Rollpopptery/wombat2/README.md

# Wombat II

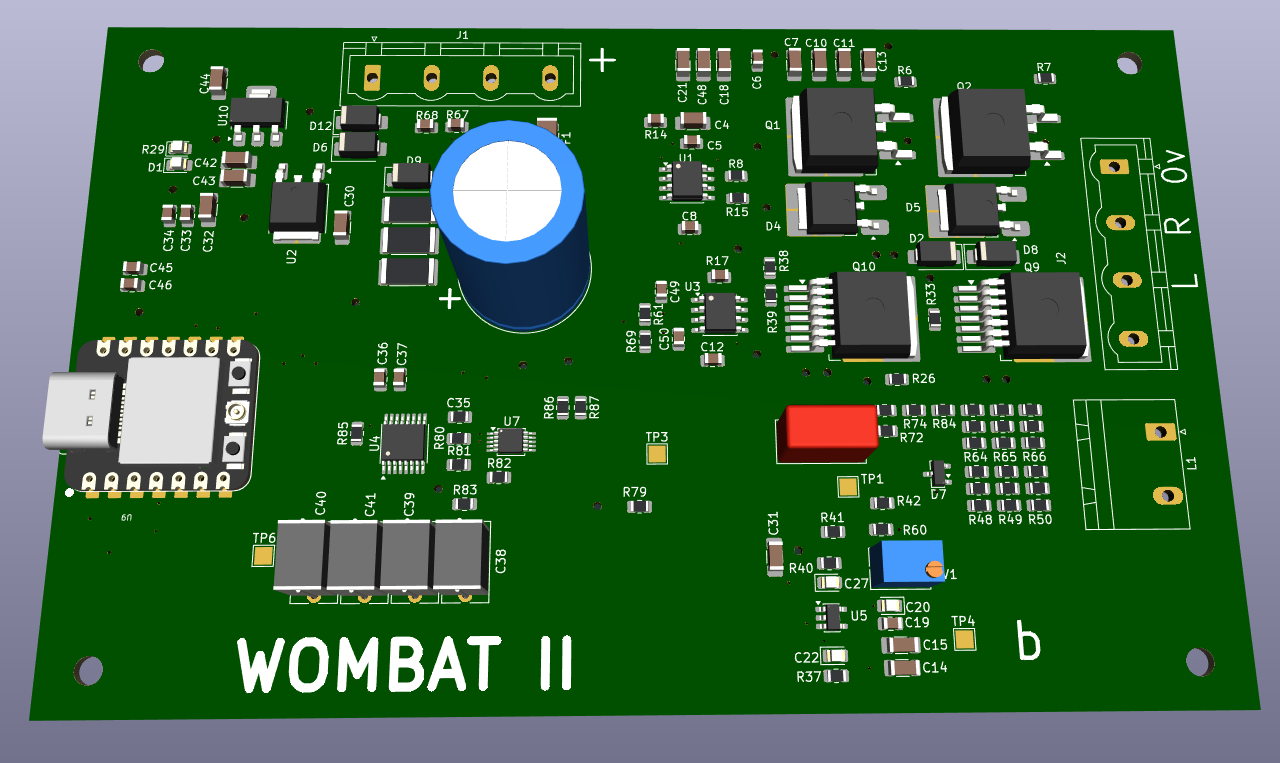
[picture p1: images/wombat2-pcb.png]
Wombat II PCB


## Repository layout

- `circuit/` — KiCad schematic and PCB design
- `software/` — all software
