Rollpopptery/wombat2/circuit/wombat2/wombat2.kicad_pcb

## KiCad design circuit/wombat2/wombat2.kicad_pcb (2026-08-06)

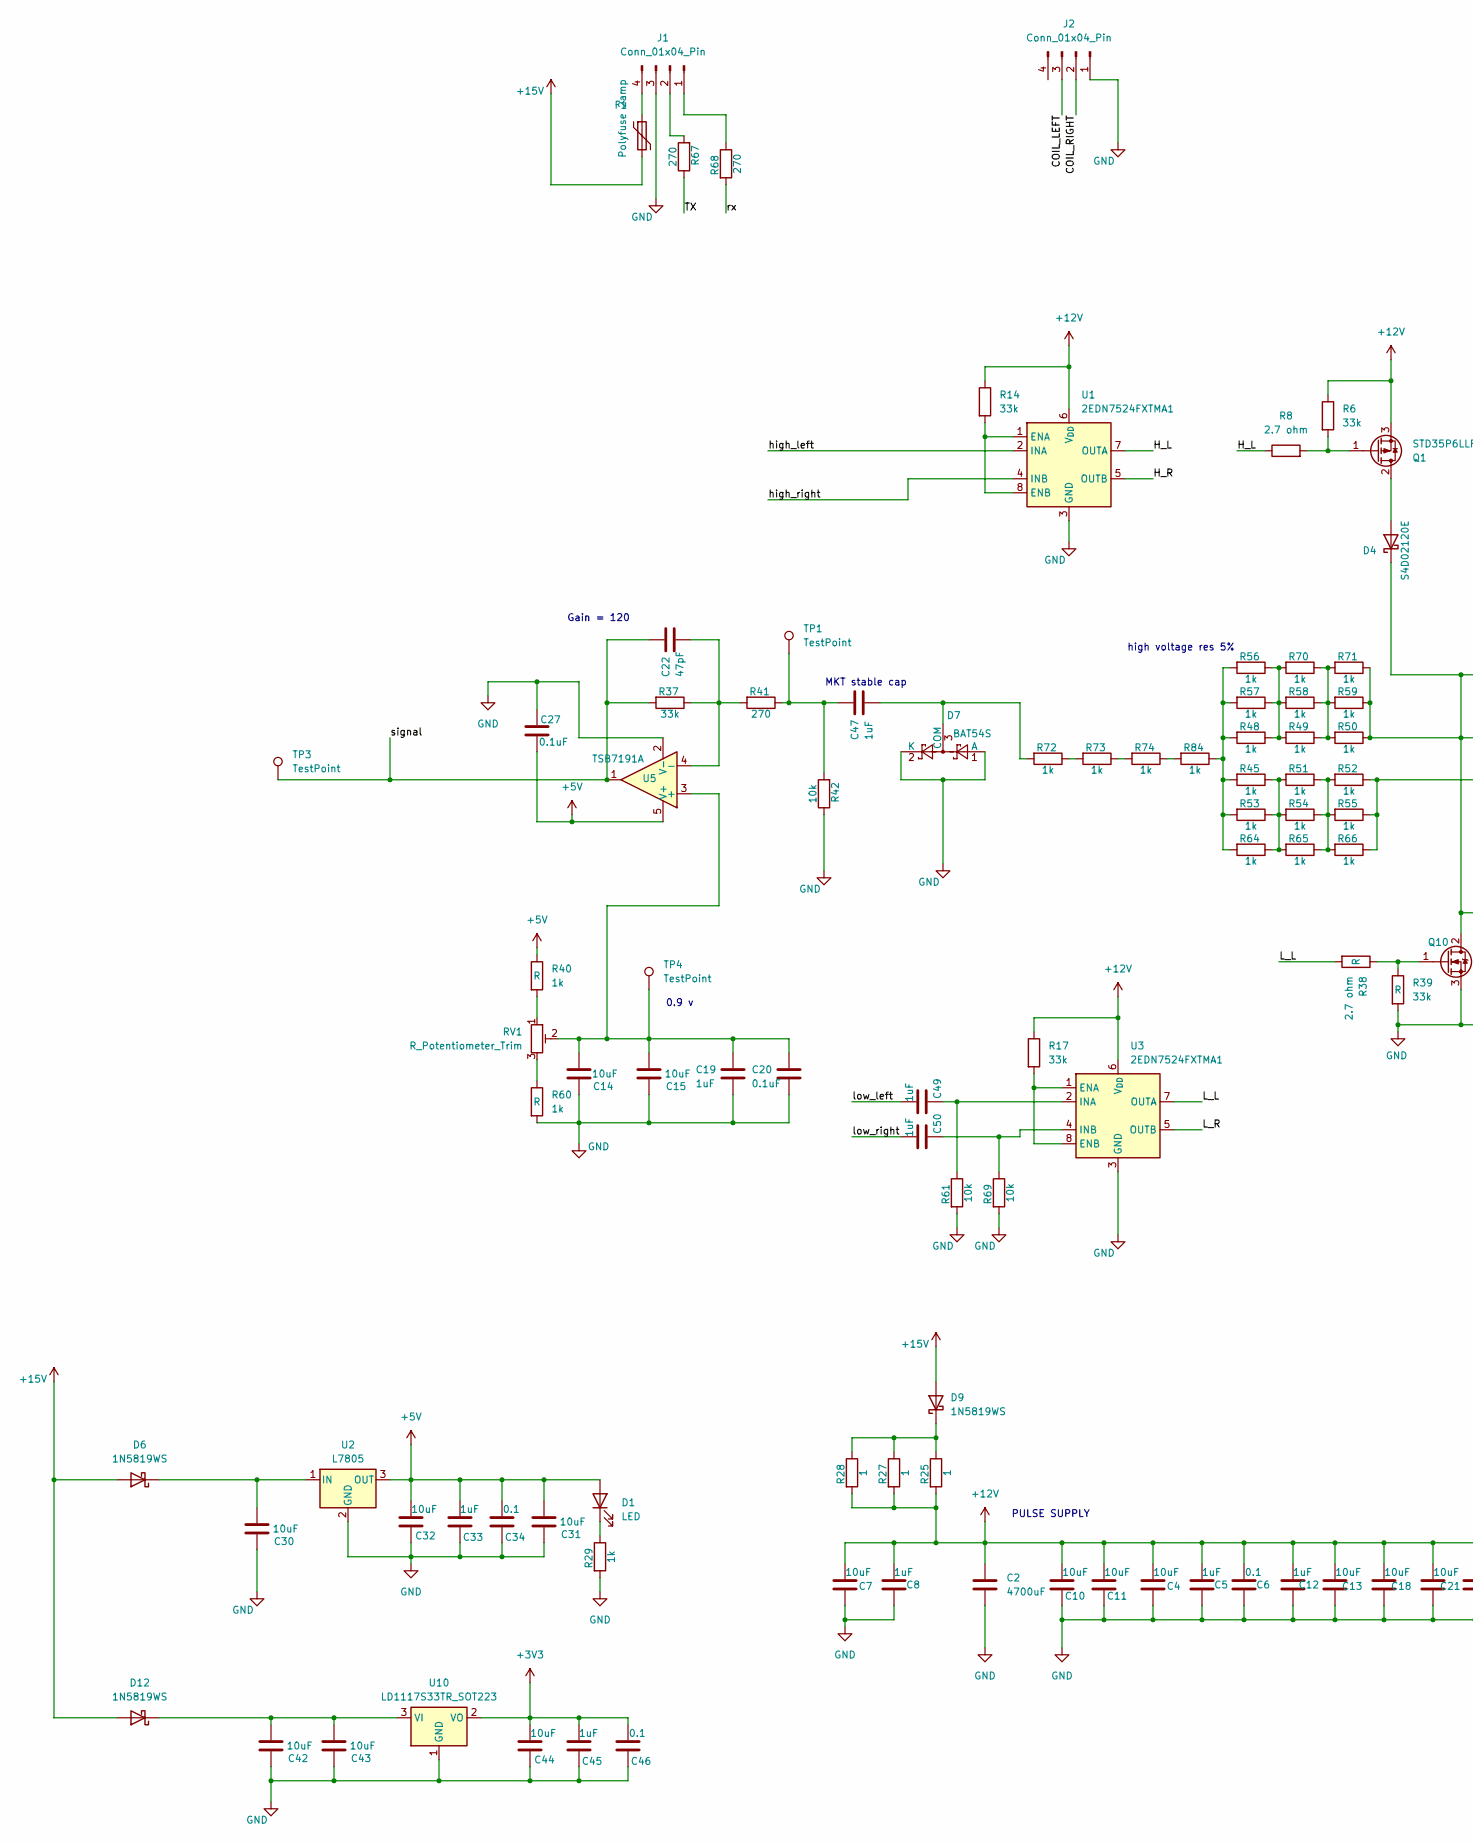
[picture p2: schematic wombat2.kicad_sch, WOMBAT 2, part in row 1, column 1]

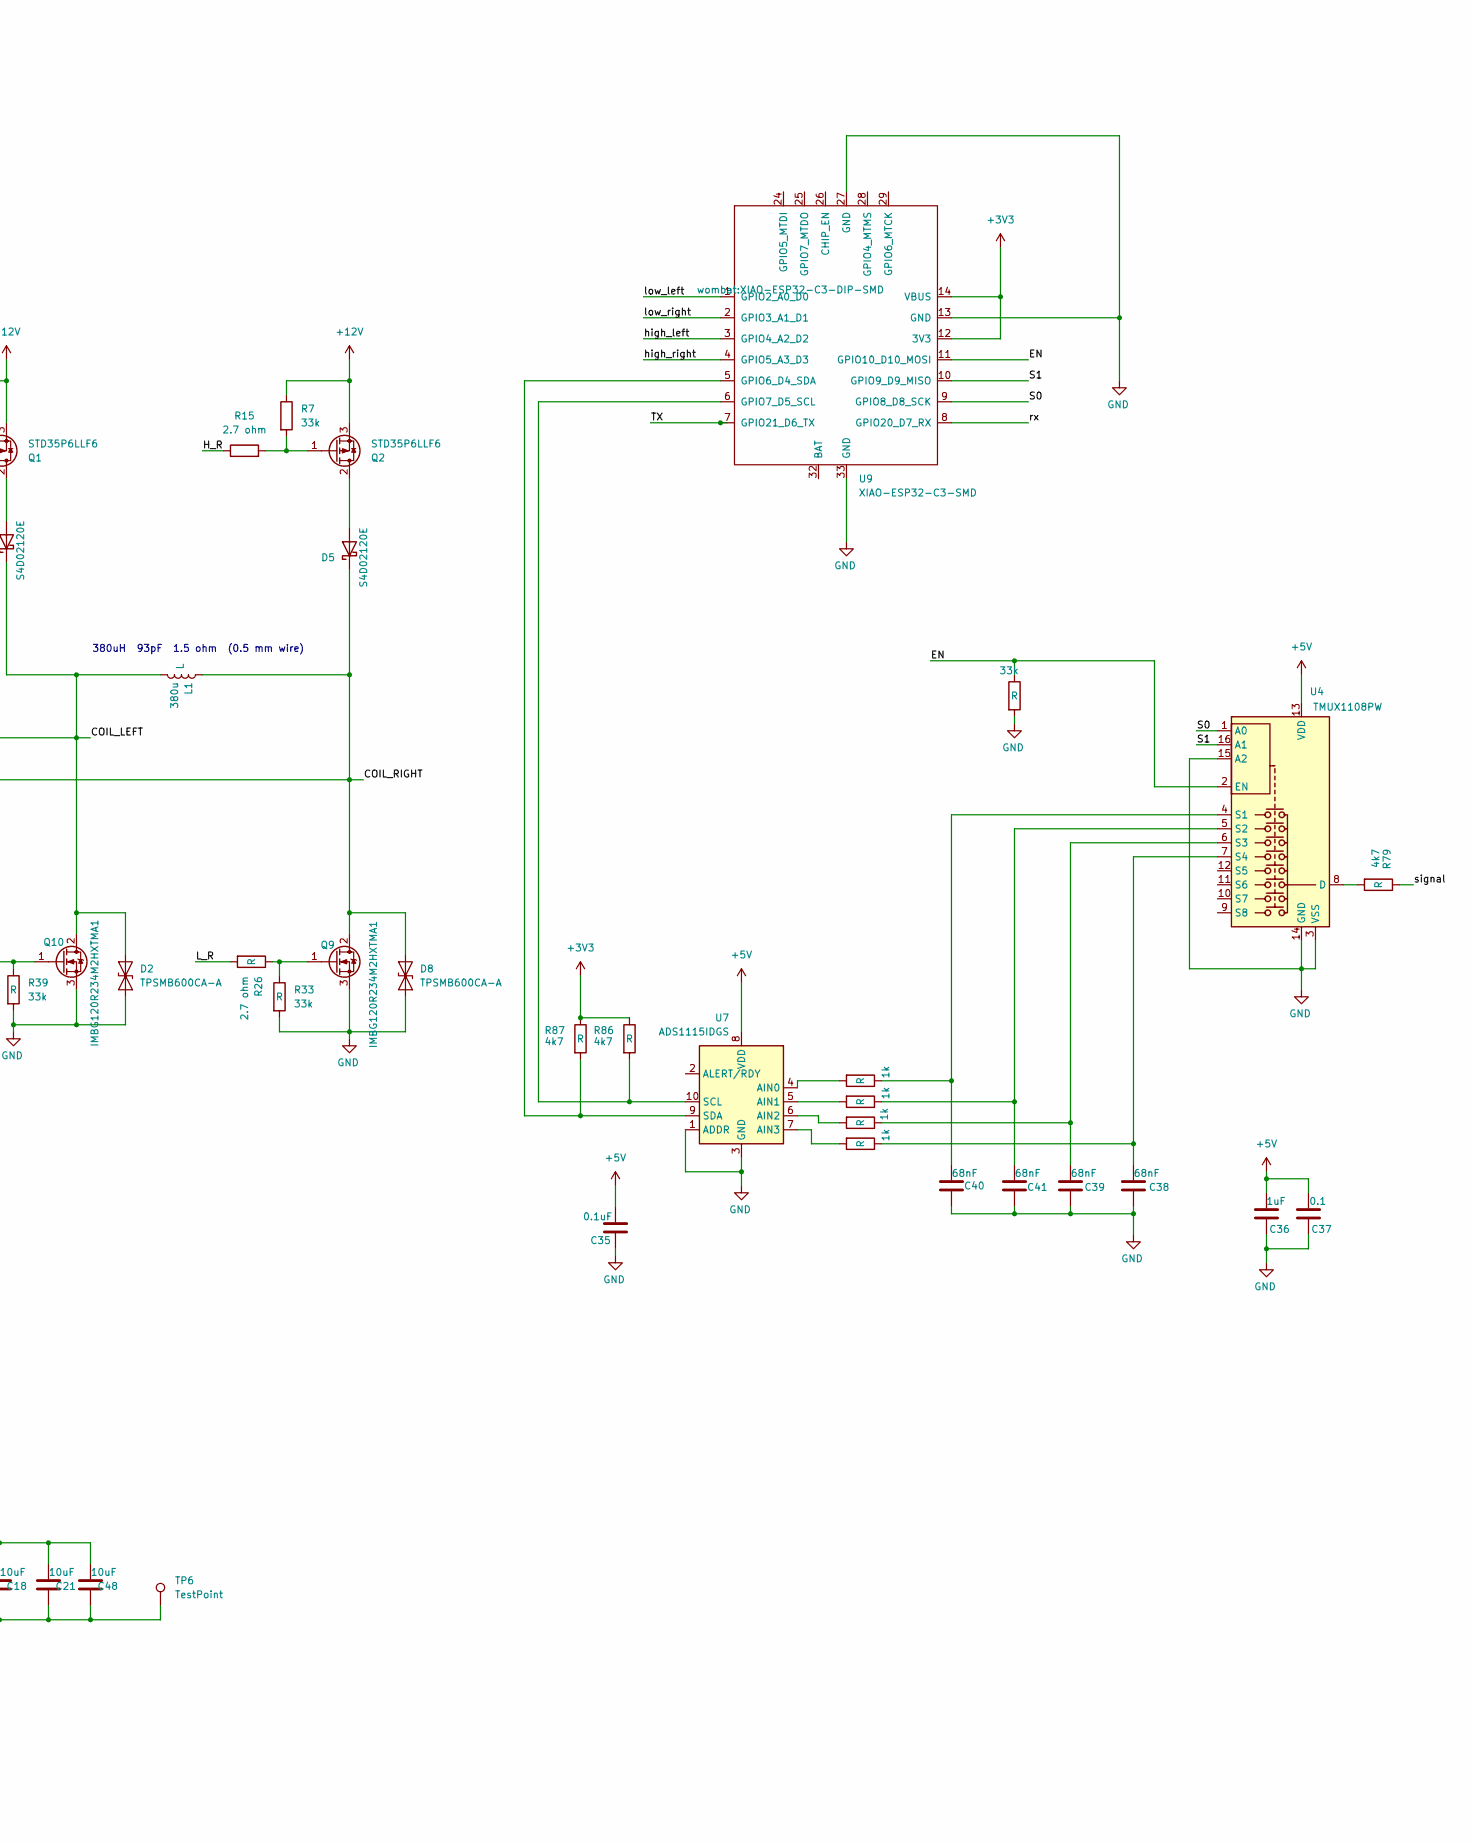
[picture p3: schematic wombat2.kicad_sch, WOMBAT 2, part in row 1, column 2]

Parts:
C2: 4700uF; C_Radial_D16.0mm_H25.0mm_P7.50mm
C4, C7, C10, C11, C13, C15, C18, C21, C30, C31, C32, C42, C43, C44, C48: 10uF; C_1206_3216Metric_Pad1.33x1.80mm_HandSolder
C5, C8, C12, C19, C33, C36, C45, C49, C50: 1uF; C_0805_2012Metric
C6, C34, C37, C46: 0.1; C_0805_2012Metric
C14: 10uF; C_1206_3216Metric
C20, C27: 0.1uF; LED_0805_2012Metric
C22: 47pF; LED_0805_2012Metric
C35: 0.1uF
C38, C39, C40, C41: 68nF; C_Rect_L9.0mm_W5.1mm_P7.50mm_MKT
C47: 1uF; C_Rect_L10.3mm_W5.0mm_P7.50mm_MKS4
D1: LED; LED_0805_2012Metric_Pad1.15x1.40mm_HandSolder
D2, D8: TPSMB600CA-A; D_SMA
D4, D5: S4D02120E; TO-252-2_TabPin1
D6, D9, D12: 1N5819WS; D_SMA
D7: BAT54S; SOT-23
F1: Polyfuse 2amp; C_1210_3225Metric
J1, J2: Conn_01x04_Pin; PhoenixContact_GMSTBVA_2,5_4-G_1x04_P7.50mm_Vertical
L1: 380u; PhoenixContact_GMSTBA_2,5_2-G-7,62_1x02_P7.62mm_Horizontal
Q1, Q2: STD35P6LLF6; TO-263-2
Q9, Q10: IMBG120R234M2HXTMA1; TO-263-7_TabPin4
R6, R7, R33, R37, R39, R85: 33k; R_0805_2012Metric
R8, R15, R26, R38: 2.7 ohm; R_0805_2012Metric
R14, R17: 33k; C_0805_2012Metric
R25, R27, R28: 1; R_2512_6332Metric
R29: 1k; LED_0805_2012Metric
R40, R45, R48, R49, R50, R51, R52, R53, R54, R55, R56, R57, R58, R59, R60, R64, R65, R66, R70, R71, R72, R73, R74, R80, R81, R82, R83, R84: 1k; R_0805_2012Metric
R41: 270; R_0805_2012Metric
R42, R61, R69: 10k; R_0805_2012Metric
R67, R68: 270; C_0805_2012Metric
R79, R86, R87: 4k7; R_0805_2012Metric
RV1: R_Potentiometer_Trim; Potentiometer_Bourns_3266Y_Vertical
TP1, TP3, TP4, TP6: TestPoint; TestPoint_Pad_2.0x2.0mm
U1, U3: 2EDN7524FXTMA1; SOIC-8_3.9x4.9mm_P1.27mm
U2: L7805; TO-252-2
U4: TMUX1108PW; TSSOP-16_4.4x5mm_P0.65mm
U5: TSB7191A; SOT-23-5
U7: ADS1115IDGS; TSSOP-10_3x3mm_P0.5mm
U9: XIAO-ESP32-C3-SMD; XIAO-ESP32-C3-DIP-SMD
U10: LD1117S33TR_SOT223; SOT-223-3_TabPin2

Connections:
+3V3: C44.2, C45.2, C46.2, R86.1, R87.1, U9.12 (3V3), U9.14 (VBUS), U10.2 (VO)
+5V: C27.2, C31.2, C32.2, C33.2, C34.2, C35.2, C36.2, C37.2, D1.2 (A), R40.1, U2.3 (OUT), U4.13 (VDD), U5.5 (V+), U7.8 (VDD)
+12V: C2.1, C4.2, C5.2, C6.2, C7.2, C8.2, C10.2, C11.2, C12.2, C13.2, C18.2, C21.2, C48.2, Q1.3 (S), Q2.3 (S), R6.1, R7.1, R14.1, R17.1, R25.2, R27.2, R28.2, U1.6 (V_{DD}), U3.6 (V_{DD})
+15V: D6.2 (A), D9.2 (A), D12.2 (A), F1.2
/COIL_LEFT: D2.2 (A2), D4.1 (K), J2.3, L1.2, Q10.2 (D), R50.1, R59.1, R71.1
/COIL_RIGHT: D5.1 (K), D8.2 (A2), J2.2, L1.1, Q9.2 (D), R52.1, R55.1, R66.1
/EN: R85.1, U4.2 (EN), U9.11 (GPIO10_D10_MOSI)
/H_L: R8.1, U1.7 (OUTA)
/H_R: R15.1, U1.5 (OUTB)
/L_L: R38.2, U3.7 (OUTA)
/L_R: R26.2, U3.5 (OUTB)
/S0: U4.1 (A0), U9.9 (GPIO8_D8_SCK)
/S1: U4.16 (A1), U9.10 (GPIO9_D9_MISO)
/TX: R67.1, U9.7 (GPIO21_D6_TX)
/high_left: U1.2 (INA), U9.3 (GPIO4_A2_D2)
/high_right: U1.4 (INB), U9.4 (GPIO5_A3_D3)
/low_left: C49.2, U9.1 (GPIO2_A0_D0)
/low_right: C50.2, U9.2 (GPIO3_A1_D1)
/rx: R68.2, U9.8 (GPIO20_D7_RX)
/signal: C22.1, R37.2, R79.1, TP3.1 (1_1), U5.1
GND: C2.2, C4.1, C5.1, C6.1, C7.1, C8.1, C10.1, C11.1, C12.1, C13.1, C14.1, C15.1, C18.1, C19.2, C20.2, C21.1, C27.1, C30.1, C31.1, C32.1, C33.1, C34.1, C35.1, C36.1, C37.1, C38.1, C39.1, C40.1, C41.1, C42.1, C43.1, C44.1, C45.1, C46.1, C48.1, D2.1 (A1), D7.1 (A), D7.2 (K), D8.1 (A1), J1.3, J2.1, Q9.3 (S), Q10.3 (S), R29.2, R33.2, R39.2, R42.1, R60.2, R61.2, R69.2, R85.2, TP6.1 (1_1), U1.3 (GND), U2.2 (GND), U3.3 (GND), U4.3 (VSS), U4.14 (GND), U4.15 (A2), U5.2 (V-), U7.1 (ADDR), U7.3 (GND), U9.13 (GND), U9.27 (GND), U9.33 (GND), U10.1 (GND)
unnamed: C47.1, R41.1, R42.2, TP1.1 (1_1)
unnamed: D1.1 (K), R29.1
unnamed: D4.2 (A), Q1.2 (D)
unnamed: D5.2 (A), Q2.2 (D)
unnamed: C30.2, D6.1 (K), U2.1 (IN)
unnamed: C47.2, D7.3 (COM), R72.2
unnamed: D9.1 (K), R25.1, R27.1, R28.1
unnamed: C42.2, C43.2, D12.1 (K), U10.3 (VI)
unnamed: J1.1, R68.1
unnamed: J1.2, R67.2
unnamed: F1.1, J1.4
unnamed: Q1.1 (G), R6.2, R8.2
unnamed: Q2.1 (G), R7.2, R15.2
unnamed: Q9.1 (G), R26.1, R33.1
unnamed: Q10.1 (G), R38.1, R39.1
unnamed: R40.2, RV1.1
unnamed: R45.1, R51.2, R53.1, R54.2, R64.1, R65.2
unnamed: R45.2, R48.2, R53.2, R56.2, R57.2, R64.2, R84.1
unnamed: R48.1, R49.2, R56.1, R57.1, R58.2, R70.2
unnamed: R49.1, R50.2, R58.1, R59.2, R70.1, R71.2
unnamed: R51.1, R52.2, R54.1, R55.2, R65.1, R66.2
unnamed: R60.1, RV1.3
unnamed: R72.1, R73.2
unnamed: R73.1, R74.2
unnamed: R74.1, R84.2
unnamed: R14.2, U1.1 (ENA), U1.8 (ENB)
unnamed: R17.2, U3.1 (ENA), U3.8 (ENB)
unnamed: C49.1, R61.1, U3.2 (INA)
unnamed: C50.1, R69.1, U3.4 (INB)
unnamed: R79.2, U4.8 (D)
unnamed: C40.2, R80.1, U4.4 (S1)
unnamed: C41.2, R81.1, U4.5 (S2)
unnamed: C39.2, R82.1, U4.6 (S3)
unnamed: C38.2, R83.1, U4.7 (S4)
unnamed: C14.2, C15.2, C19.1, C20.1, RV1.2, TP4.1 (1_1), U5.3 (+)
unnamed: C22.2, R37.1, R41.2, U5.4 (-)
unnamed: R80.2, U7.4 (AIN0)
unnamed: R81.2, U7.5 (AIN1)
unnamed: R82.2, U7.6 (AIN2)
unnamed: R83.2, U7.7 (AIN3)
unnamed: R86.2, U7.10 (SCL), U9.6 (GPIO7_D5_SCL)
unnamed: R87.2, U7.9 (SDA), U9.5 (GPIO6_D4_SDA)

Notes on the sheet:
PULSE SUPPLY
Gain = 120
MKT stable cap
380uH 93pF 1.5 ohm (0.5 mm wire)
0.9 v
high voltage res 5%

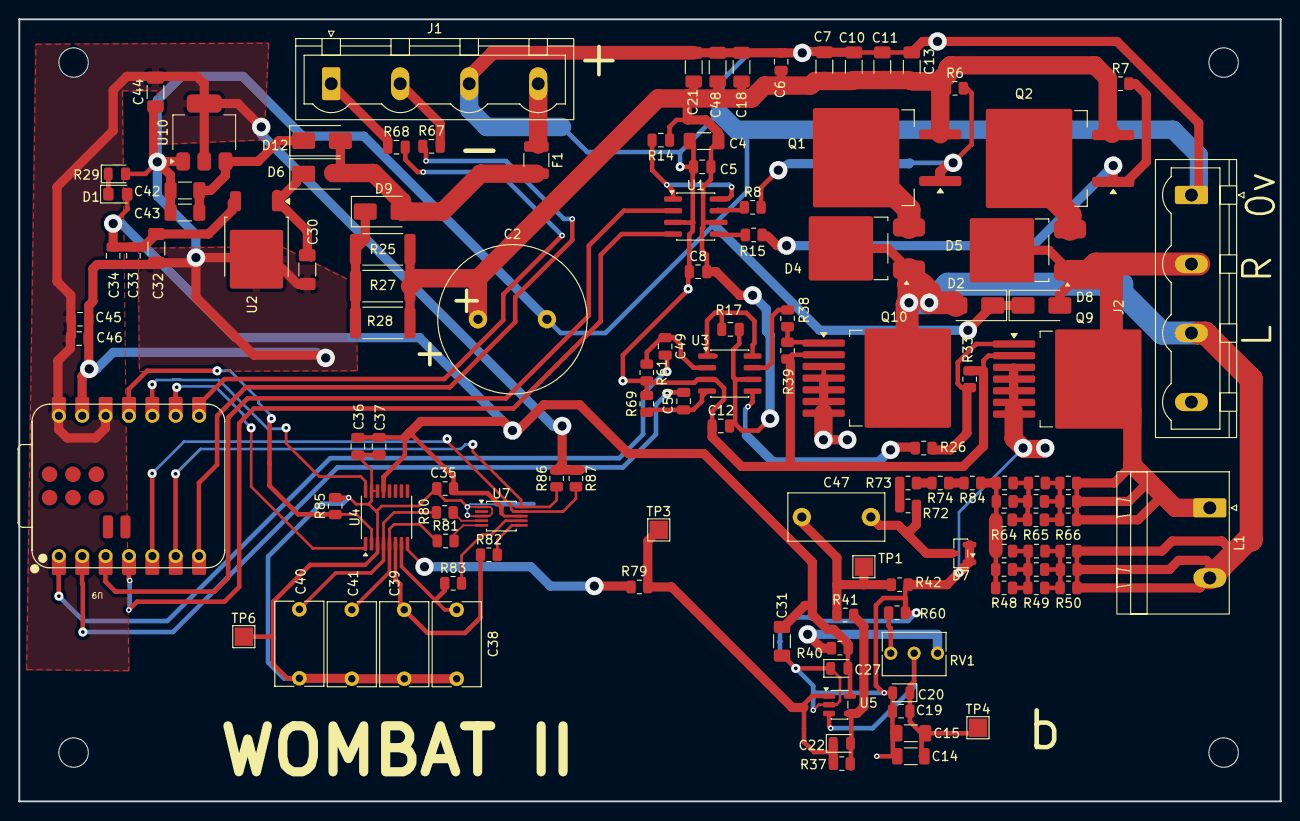
[picture p4: board wombat2.kicad_pcb from above]

Board: 2 copper layers, 137.1 x 85.0 mm, 122 parts (0 on the bottom side), 63 nets.
