Rollpopptery/wombat2/software/wombat2b/wombat2b.ino

/*
  wombat2 - bipolar pulse-induction metal detector
  Seeed Studio XIAO ESP32-C3

  Sketch entry tab (matches the folder name). The pulse engine and sampling
  live in wombat_bipolar_pulse_c3.ino; Arduino compiles all .ino tabs together.
*/
