Rollpopptery/wombat2/(commit log)

2026-08-05 Initial commit: wombat2 bipolar pulse-induction metal detector
    Firmware (XIAO ESP32-C3 pulse/damping engine + ADS1115 sampling) and KiCad
    schematic/PCB/project. MIT licensed.
    [wombat2.kicad_pcb, wombat2.kicad_sch]
2026-08-05 Bipolar drive + long low-side measurement hold; persist tuned hard-off to NVS
    - Alternate LEFT/RIGHT diagonals each pulse; mirrored low-side discharge, shared timing
    - Replace short busy-wait discharge with a tick-scheduled ~100us low-side hold
    - Save tuned hard-off (g_hardoff_cyc) to NVS via Preferences; restore on boot ('s' key)
    - Serial output in Arduino Serial Plotter format ('=' also nudges hard-off)
    - Pulse rate back to 4 Hz for bipolar bring-up
    - Strip legacy port references from comments; MIT header
    [wombat_bipolar_pulse_c3.ino]
2026-08-06 Update KiCad schematic/PCB; track custom footprint library
    - Whitelist Library.pretty/*.kicad_mod in the circuit .gitignore so the
    custom footprints are versioned (symbol libs / fp-lib-table still excluded)
    - Update schematic, PCB, and project file
    [wombat2.kicad_pcb, wombat2.kicad_sch]
2026-08-06 Add README with PCB render
2026-08-06 Add XIAO-ESP32-C3 footprint with 3D model; update board and schematic
    - Add XIAO-ESP32-C3-DIP-SMD footprint to the wombat library (3D model attached)
    - Repoint the board's XIAO to the wombat-library footprint
    - Update schematic and PCB
    [wombat2.kicad_pcb, wombat2.kicad_sch]
